choco-robot/HomeBot/docs/人体检测与跟随方案.md

# HomeBot 人体检测与跟随功能设计方案

**版本**: v2.0 (更新为YOLO26)  
**日期**: 2026-03-09  
**状态**: 待确认

---

## 1. 功能概述

实现机器人的**人体检测**和**自动跟随**功能：
- **人体检测**：实时识别画面中的人体位置
- **目标跟踪**：稳定跟踪特定目标（避免频繁切换）
- **自动跟随**：根据目标位置控制底盘移动，保持固定距离

---

## 2. 系统架构

### 2.1 模块架构

```
┌─────────────────────────────────────────────────────────────┐
│                   Application: human_follow                   │
│  ┌─────────────┐  ┌─────────────┐  ┌─────────────────────┐ │
│  │ Human       │  │ Target      │  │ FollowController    │ │
│  │ Detector    │→ │ Tracker     │→ │ (vx, vy, vz)       │ │
│  │ (YOLO26n)   │  │ (IoU/Kalman)│  │                     │ │
│  └─────────────┘  └─────────────┘  └─────────────────────┘ │
└─────────────────────────────────────────────────────────────┘
                              │
                              ↓ ZeroMQ REQ
┌─────────────────────────────────────────────────────────────┐
│                   Service: ChassisService                     │
│                    (接收跟随控制指令)                          │
└─────────────────────────────────────────────────────────────┘
                              ↑
                              │ ZeroMQ SUB
┌─────────────────────────────────────────────────────────────┐
│                   Service: VisionService                      │
│                    (发布摄像头图像帧)                          │
└─────────────────────────────────────────────────────────────┘
```

### 2.2 数据流

```
VisionService ──(ZMQ PUB)──→ human_follow ──(ZMQ REQ)──→ ChassisService
      │                           │                          │
   Camera帧                   检测+跟踪                    执行速度
   (MJPEG)                    计算速度指令                  控制底盘
```

---

## 3. 技术方案选型

### 3.1 人体检测方案对比

| 方案 | 速度 | 精度 | CPU占用 | 模型大小 | 推荐度 |
|---|---|---|---|---|---|
| **YOLO26-nano** | ⭐⭐⭐⭐⭐ | ⭐⭐⭐⭐ | 极低 | 2.4MB | ⭐⭐⭐⭐⭐ |
| YOLO11-nano | ⭐⭐⭐⭐ | ⭐⭐⭐⭐ | 低 | 2.6MB | ⭐⭐⭐⭐ |
| YOLOv8-nano | ⭐⭐⭐ | ⭐⭐⭐ | 低 | 3.2MB | ⭐⭐⭐ |
| MediaPipe | ⭐⭐⭐⭐ | ⭐⭐ | 极低 | - | ⭐⭐ |

**最终选择**: **YOLO26-nano** (2026年1月发布)
- **模型大小**: ~2.4MB（比YOLO11小8%，比YOLOv8小25%）
- **CPU速度**: 38.9ms/帧，比YOLO11快**43%**
- **精度**: 40.9% mAP（COCO），比YOLO11高1.4%
- **边缘优化**: 移除DFL模块，无NMS后处理，部署更简单

### 3.2 YOLO26 关键优势

| 特性 | YOLO26 | 说明 |
|---|---|---|
| **端到端推理** | ✅ NMS-free | 直接输出结果，无需后处理，延迟更低 |
| **DFL移除** | ✅ | 架构简化，支持更多导出格式 |
| **小目标检测** | ✅ ProgLoss+STAL | 专门优化小目标检测精度 |
| **量化稳定** | ✅ | FP16/FP32精度一致，适合INT8部署 |
| **MuSGD优化器** | ✅ | 训练更稳定，泛化能力更强 |

### 3.3 目标跟踪方案

| 方案 | 特点 | 适用场景 |
|---|---|---|
| **IoU匹配** | 简单、无状态 | 目标不重叠时 |
| **卡尔曼滤波** | 预测运动轨迹 | 目标短暂遮挡 |
| **DeepSORT** | 外观+运动特征 | 多目标、复杂场景 |

**推荐方案**: IoU匹配 + 卡尔曼滤波（混合）
- 轻量实现，适合树莓派/Jetson
- 处理简单跟随场景足够

### 3.4 跟随控制算法

**控制策略**：视觉伺服（Visual Servoing）

```python
# 控制逻辑伪代码
def compute_velocity(target_bbox, frame_width, frame_height):
    """
    根据目标位置计算底盘速度
    目标：将目标保持在画面中央，保持固定距离
    """
    cx, cy = get_bbox_center(target_bbox)
    area = get_bbox_area(target_bbox)
    
    # 1. 水平控制（角速度 vz）
    # 目标在画面左侧 → 左转，右侧 → 右转
    error_x = cx - frame_width / 2
    vz = Kp_angular * error_x  # P控制器
    
    # 2. 距离控制（线速度 vx）
    # 目标太小 → 靠近，太大 → 后退
    target_area = (frame_width * 0.3) * (frame_height * 0.5)  # 期望目标大小
    error_area = target_area - area
    vx = Kp_linear * error_area
    
    # 3. 速度限制
    vx = clamp(vx, -MAX_LINEAR_SPEED, MAX_LINEAR_SPEED)
    vz = clamp(vz, -MAX_ANGULAR_SPEED, MAX_ANGULAR_SPEED)
    
    return vx, 0, vz  # vy = 0（不前移不后退）
```

---

## 4. 详细设计

### 4.1 目录结构

```
software/
├── src/
│   ├── applications/
│   │   └── human_follow/
│   │       ├── __init__.py              # 入口脚本
│   │       ├── follow.py                # 主控制逻辑
│   │       ├── detector.py              # 人体检测器（YOLO26）
│   │       ├── tracker.py               # 目标跟踪器
│   │       └── controller.py            # 跟随控制器
│   ├── configs/
│   │   └── config.py                    # 新增HumanFollowConfig
│   └── models/                          # 模型文件目录
│       └── yolo26n.pt                   # YOLO26 nano模型 (~2.4MB)
├── tools/
│   └── download_models.py               # 模型下载脚本
```

### 4.2 类设计

#### 4.2.1 HumanDetector (人体检测器)

```python
class HumanDetector:
    """人体检测器 - 使用YOLO26"""
    
    def __init__(self, model_path: str, conf_threshold: float = 0.5):
        """
        Args:
            model_path: YOLO26模型文件路径
            conf_threshold: 置信度阈值
        """
        from ultralytics import YOLO
        self.model = YOLO(model_path)
        self.conf_threshold = conf_threshold
    
    def detect(self, frame: np.ndarray) -> List[Detection]:
        """
        检测图像中的人体
        
        Returns:
            List[Detection]: 检测框列表，每个包含:
                - bbox: [x1, y1, x2, y2]
                - confidence: 置信度
                - class_id: 类别ID (person=0)
        """
        results = self.model(frame, conf=self.conf_threshold, classes=[0])
        # 解析results为Detection列表
        return detections
```

#### 4.2.2 TargetTracker (目标跟踪器)

```python
class TargetTracker:
    """目标跟踪器 - IoU匹配 + 卡尔曼滤波"""
    
    def __init__(self, max_age: int = 30, min_iou: float = 0.3):
        """
        Args:
            max_age: 最大丢失帧数，超过则删除跟踪目标
            min_iou: 匹配最小IoU阈值
        """
        pass
    
    def update(self, detections: List[Detection]) -> Optional[Target]:
        """
        更新跟踪状态
        
        Args:
            detections: 当前帧检测结果
            
        Returns:
            Target: 当前跟踪目标（如果有）
        """
        pass
    
    def select_target(self, detections: List[Detection], 
                      strategy: str = "center") -> Target:
        """
        从多个检测中选择目标
        
        Args:
            strategy: 选择策略
                - "center": 选择画面中央的目标（默认）
                - "largest": 选择最大的目标
                - "closest": 选择最靠近摄像头的目标（框最大）
        """
        pass
```

#### 4.2.3 FollowController (跟随控制器)

```python
class FollowController:
    """跟随控制器 - 视觉伺服"""
    
    def __init__(self, config: FollowConfig):
        """
        Args:
            config: 跟随控制配置
        """
        pass
    
    def compute_velocity(self, target: Target, 
                         frame_shape: Tuple[int, int]) -> Tuple[float, float, float]:
        """
        计算跟随速度
        
        Returns:
            (vx, vy, vz): 线速度和角速度
        """
        pass
    
    def is_lost(self) -> bool:
        """判断目标是否丢失"""
        pass
    
    def reset(self):
        """重置控制器状态"""
        pass
```

#### 4.2.4 HumanFollowApp (主应用)

```python
class HumanFollowApp:
    """人体跟随主应用"""
    
    def __init__(self):
        # 初始化视觉订阅
        self.vision_sub = VisionSubscriber()
        # 初始化底盘客户端
        self.chassis_client = ChassisClient()
        # 初始化检测器、跟踪器、控制器
        self.detector = HumanDetector()
        self.tracker = TargetTracker()
        self.controller = FollowController()
        
    def run(self):
        """主循环"""
        while running:
            # 1. 获取图像
            frame_id, frame = self.vision_sub.read_frame()
            
            # 2. 检测人体
            detections = self.detector.detect(frame)
            
            # 3. 更新跟踪
            target = self.tracker.update(detections)
            
            # 4. 计算速度
            if target:
                vx, vy, vz = self.controller.compute_velocity(target, frame.shape)
                # 5. 发送控制命令
                self.chassis_client.send_velocity(vx, vy, vz, source="auto")
            else:
                # 目标丢失，停止或搜索
                self.chassis_client.stop()
```

### 4.3 配置设计

```python
@dataclass
class HumanFollowConfig:
    """人体跟随配置（YOLO26版）"""
    # 模型配置
    model_path: str = "models/yolo26n.pt"     # YOLO26 nano (~2.4MB)
    conf_threshold: float = 0.5
    
    # 跟踪配置
    max_tracking_age: int = 30        # 最大丢失帧数
    min_iou_threshold: float = 0.3    # 匹配阈值
    target_selection: str = "center"  # 目标选择策略
    
    # 推理优化（边缘设备）
    inference_size: int = 320         # 输入分辨率 320x320
    use_half_precision: bool = True   # FP16半精度推理
    
    # 跟随控制配置
    target_distance: float = 1.0      # 目标距离（米，通过框大小估算）
    kp_linear: float = 0.001          # 线速度P系数
    kp_angular: float = 0.003         # 角速度P系数
    max_linear_speed: float = 0.3     # 最大线速度
    max_angular_speed: float = 0.8    # 最大角速度
    dead_zone_x: int = 50             # 水平死区（像素）
    
    # 安全配置
    timeout_ms: int = 1000            # 通信超时
    stop_on_lost: bool = True         # 丢失目标时是否停止
```

---

## 5. 通信协议

### 5.1 控制命令格式

```json
{
    "source": "auto",
    "vx": 0.2,
    "vy": 0.0,
    "vz": 0.1,
    "priority": 3
}
```

- `source`: "auto" - 自动跟随控制源
- `priority`: 3 - 与仲裁器优先级定义一致（web=1, voice=2, auto=3, emergency=4）

### 5.2 视觉检测结果（可选扩展）

如需发布检测结果供其他模块使用：

```json
{
    "type": "detection.human",
    "timestamp": 1709568000,
    "data": {
        "targets": [
            {
                "id": 1,
                "bbox": [100, 200, 300, 400],
                "confidence": 0.95,
                "center": [200, 300]
            }
        ],
        "tracking": {
            "target_id": 1,
            "status": "tracking"
        }
    }
}
```

---

## 6. 异常处理与安全机制

### 6.1 异常场景处理

| 场景 | 处理策略 |
|---|---|
| **目标丢失** | 停止移动，原地旋转搜索或等待 |
| **多目标** | 按策略选择（中央/最大/最近） |
| **目标遮挡** | 卡尔曼滤波预测，最多持续N帧 |
| **通信中断** | 停止底盘，记录日志 |
| **检测失败** | 重试，连续失败则停止 |

### 6.2 安全机制

1. **速度限制**：配置最大线速度和角速度上限
2. **急停响应**：监听紧急停止信号，立即释放控制权
3. **超时保护**：通信超时自动停止底盘
4. **边界检测**：结合视觉避障，避免碰撞

---

## 7. 性能优化

### 7.1 YOLO26 推理优化

| 优化手段 | 说明 | 预期提升 |
|---|---|---|
| **输入分辨率降低** | 320x320 替代 640x640 | 4x速度提升 |
| **FP16半精度** | TensorRT/ONNX FP16 | 2x速度提升 |
| **NCNN** (ARM) | 树莓派/手机专用格式 | 2-3x速度提升 |
| **批量推理** | 一次处理多帧 | 提高吞吐量 |

### 7.2 各平台预期性能

| 平台 | 格式 | 分辨率 | 预期FPS | 延迟 |
|---|---|---|---|---|
| 树莓派5 | NCNN | 320x320 | 25-30 | ~35ms |
| Jetson Nano | TensorRT FP16 | 320x320 | 20-25 | ~45ms |
| Jetson Orin Nano | TensorRT FP16 | 640x640 | 40-50 | ~20ms |
| x86 CPU | ONNX | 320x320 | 15-20 | ~60ms |

### 7.3 控制优化

- **速度平滑**：使用低通滤波或滑动平均，避免速度突变
- **PID控制**：将P控制器升级为PID，减少抖动

---

## 8. 实现步骤

### Phase 1: 基础框架 (Day 1-2)
1. 新增配置文件 `HumanFollowConfig`
2. 实现 `HumanDetector` 类（YOLO26集成）
3. 模型下载脚本（自动下载yolo26n.pt）

### Phase 2: 跟踪与控制 (Day 3-4)
1. 实现 `TargetTracker` 类
2. 实现 `FollowController` 类
3. 视觉伺服算法调试

### Phase 3: 应用集成 (Day 5)
1. 实现 `HumanFollowApp` 主应用
2. 与底盘服务集成测试
3. 异常处理与安全机制

### Phase 4: 优化与测试 (Day 6-7)
1. 性能优化（异步、跳帧）
2. 参数调优
3. 编写测试用例

---

## 9. 依赖变更

```txt
# requirements.txt 新增依赖
ultralytics>=8.3.0      # YOLO26 (需最新版支持)
numpy>=1.24.0           # 数值计算
filterpy>=1.4.5         # 卡尔曼滤波（可选）

# 边缘设备优化（可选）
onnxruntime>=1.16.0     # ONNX推理
openvino>=2024.0        # Intel CPU优化
tensorrt>=10.0          # NVIDIA Jetson
```

---

## 10. 启动方式

```bash
# 方式一：独立启动
cd software/src
python -m applications.human_follow

# 方式二：通过系统启动脚本集成
# 修改 start_system.py 添加跟随模式选项

# 方式三：从Web控制端切换模式（未来扩展）
# 遥控界面添加"跟随模式"开关
```

---

## 11. 测试计划

| 测试项 | 方法 | 预期结果 |
|---|---|---|
| 人体检测精度 | 测试视频集 | mAP > 0.7 |
| 跟踪稳定性 | 多人场景测试 | 不频繁跳换目标 |
| 跟随效果 | 真人测试 | 保持1米距离，位于画面中央 |
| 异常处理 | 遮挡、丢失测试 | 安全停止或恢复 |
| 性能 | 树莓派/Jetson | FPS > 15 |

---

## 12. 附录：YOLO 版本对比

### 12.1 YOLO26 vs YOLO11 vs YOLOv8

| 指标 | YOLO26-nano | YOLO11-nano | YOLOv8-nano | 胜出 |
|---|---|---|---|---|
| **mAP** | 40.9% | 39.5% | 37.3% | YOLO26 |
| **CPU速度** | 38.9ms | 56.1ms | 80.4ms | YOLO26 |
| **参数量** | 2.4M | 2.6M | 3.2M | YOLO26 |
| **FLOPs** | 5.4B | 6.5B | 8.7B | YOLO26 |
| **NMS-free** | ✅ | ❌ | ❌ | YOLO26 |
| **发布时间** | 2026-01 | 2024-10 | 2023-01 | - |

### 12.2 选择YOLO26的理由

1. **最快CPU推理**: 比YOLO11快43%，比YOLOv8快107%
2. **更高精度**: 在更小模型下实现更高mAP
3. **无NMS**: 端到端推理，降低延迟和部署复杂度
4. **边缘优化**: 专为嵌入式和移动设备设计
5. **API兼容**: 与YOLOv8/YOLO11完全相同的Python接口

---

## 13. 风险评估

| 风险 | 影响 | 缓解措施 |
|---|---|---|
| YOLO26太新，社区资料少 | 调试困难 | 官方文档完善，API兼容YOLOv8/11 |
| 量化精度损失 | 检测精度下降 | FP16精度一致，INT8需测试 |
| 复杂背景误检 | 跟随错误目标 | 增加置信度阈值，优化跟踪逻辑 |
| 光线变化 | 检测失败 | 测试不同光照条件 |
| 多人干扰 | 频繁切换目标 | 改进目标选择策略 |

---

## 14. 后续扩展

1. **手势控制**：识别手势指令（停止、跟随、离开）
2. **人脸识别**：跟随特定人员
3. **路径预测**：预测目标移动方向，提前调整
4. **避障集成**：跟随同时避障

---

*方案设计完成（基于YOLO26），等待确认后开始实施*
