choco-robot/HomeBot/docs/HomeBot_BOM物料清单.md

# HomeBot 机器人 BOM 物料清单

本文档列出 HomeBot 机器人的完整物料清单（Bill of Materials）。

## 物料清单

| 分类 | 序号 | 名称 | 规格/型号 | 数量 | 备注 |
|:---:|-----:|---|---|:---:|:---|
| **车身** | 1 | 宜家小车 | Raskog小号 | 1套 | 基础平台 |
| | 2 | 锂电池 | 12V 5000mAh + 电源线 | 1 | 动力电源 |
| | 3 | 锂电池充电器 | 12V 配套充电器 | 1 | 安全充电 |
| | 4 | 舵机控制板 | Bus Servo Adapter (A) | 1 | 舵机通信控制 |
| | 5 | USB摄像头 | 1080P | 1 | 视觉采集 |
| **底盘** | 6 | 底盘3D打印件 | PLA/PETG | 1套 | 底盘框架主体 |
| | 7 | 底盘舵机 | ST3215 12V | 3 | 三轮全向底盘驱动 |
| | 8 | 法兰轴 | 6mm | 3 | 舵机与轮子连接 |
| | 9 | 全向轮 + 铜联轴器 | 85mm全向轮 + 6mm铜联轴器 | 3 | 轮子组件 |
| | 10 | 螺丝螺母 | M3/M4 | 若干 | 紧固件 |
| **机械臂** | 11 | SOARM101打印件 | PLA/PETG | 1套 | 机械臂结构件 |
| | 12 | 720P USB摄像头模组 | 125°无畸变镜头 | 1 | 机械臂视觉 |

---

*最后更新：2026-03-22*
