choco-robot/HomeBot/hardware/structure/STL/dualwheelbase/轮子无刷电机支架v2.3mf

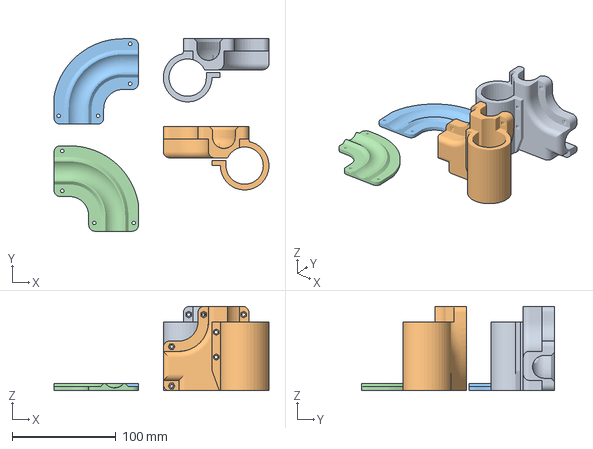
[picture p4: CAD file, 2026-06-03]
hardware/structure/STL/dualwheelbase/轮子无刷电机支架v2.3mf
207.5 x 185.8 x 81.5 mm
轮子无刷电机支架v2.STL x 2
盖板.STL x 2
