choco-robot/HomeBot/hardware/structure/STL/elevator/打孔工具.STL

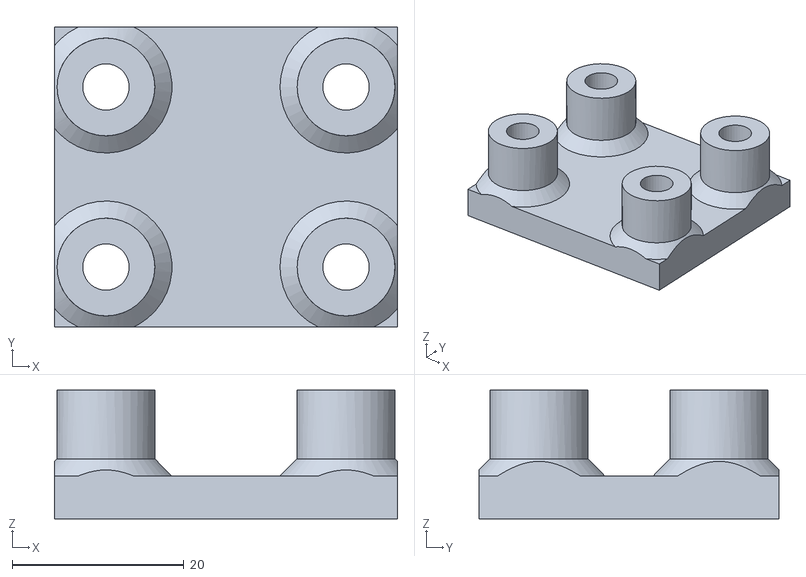
[picture p5: CAD file, 2026-03-27]
hardware/structure/STL/elevator/打孔工具.STL
40.0 x 35.0 x 15.0
