choco-robot/HomeBot/hardware/structure/STL/kiwi_base/base_plate_layer1.3mf

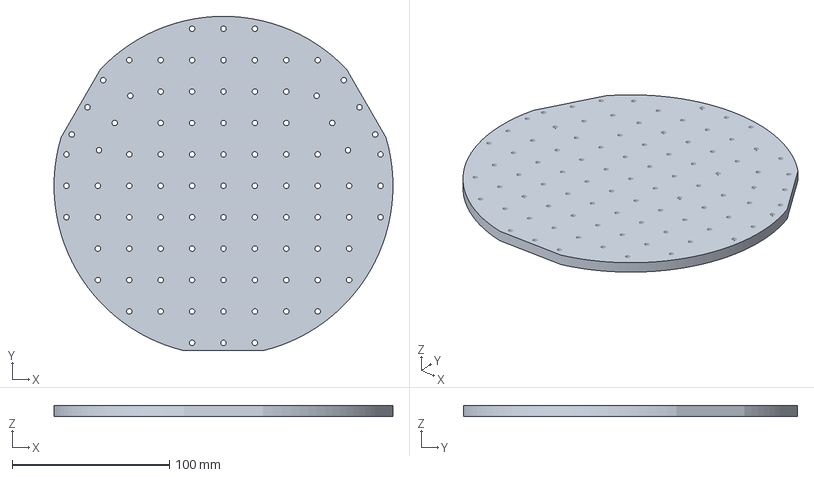
[picture p6: CAD file, 2026-06-03]
hardware/structure/STL/kiwi_base/base_plate_layer1.3mf
215.9 x 212.9 x 7.00 mm
