choco-robot/HomeBot/hardware/structure/STL/SO-ARM101_camera_wrist_mount.stl

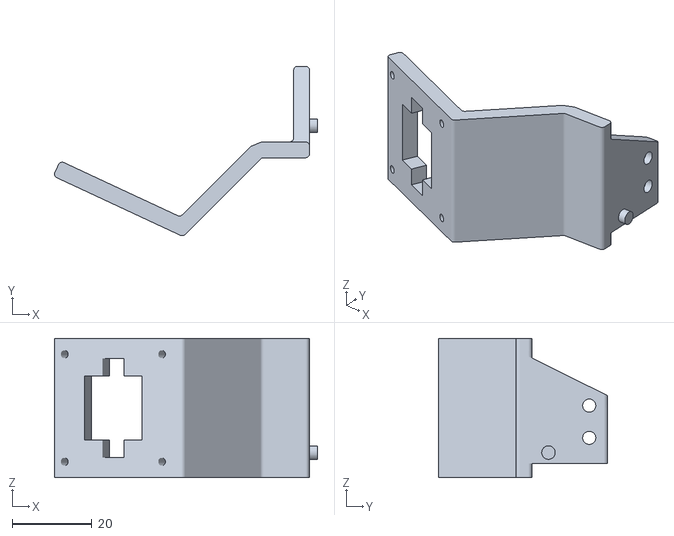
[picture p7: CAD file, 2026-03-22]
hardware/structure/STL/SO-ARM101_camera_wrist_mount.stl
66.1 x 42.6 x 35.0
