choco-robot/HomeBot/hardware/structure/URDF/SO101/assets/wrist_roll_pitch_so101_v2.stl

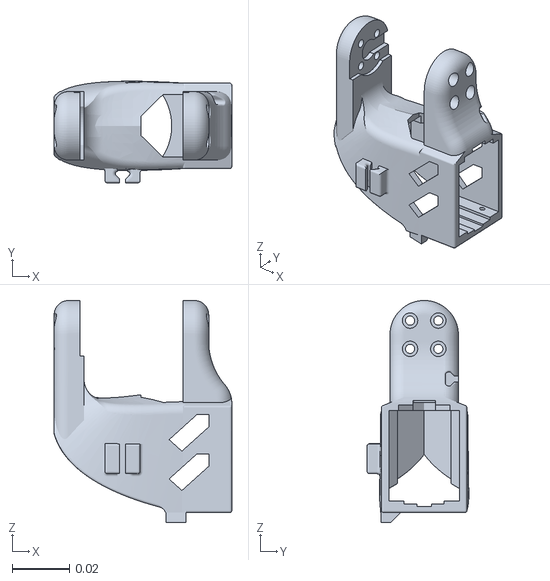
[picture p8: CAD file, 2026-04-28]
hardware/structure/URDF/SO101/assets/wrist_roll_pitch_so101_v2.stl
0.0623 x 0.0357 x 0.0778
