choco-robot/HomeBot/hardware/structure/STL/dualwheelbase/盖板.3mf

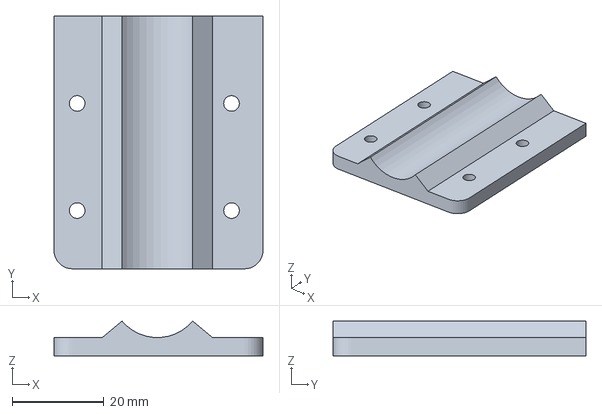
[picture p9: CAD file, 2026-06-03]
hardware/structure/STL/dualwheelbase/盖板.3mf
45.5 x 55.0 x 7.60 mm
