choco-robot/HomeBot/hardware/structure/STL/elevator/丝杆轴承连接座.STL

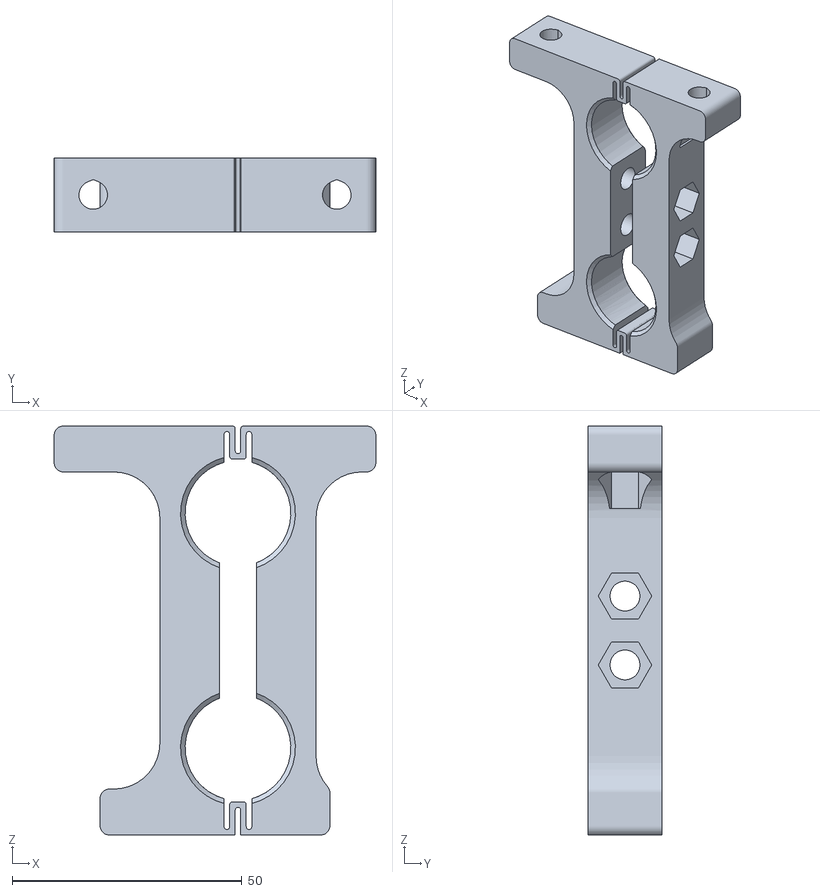
[picture p10: CAD file, 2026-03-13]
hardware/structure/STL/elevator/丝杆轴承连接座.STL
70.0 x 16.0 x 89.0
