choco-robot/HomeBot/hardware/structure/STL/kiwi_base/base_connector_45mm.3mf

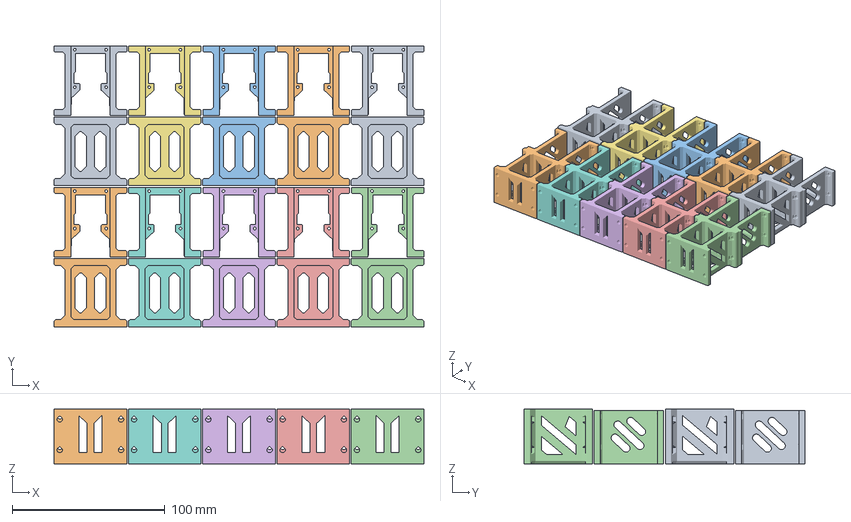
[picture p11: CAD file, 2026-06-03]
hardware/structure/STL/kiwi_base/base_connector_45mm.3mf
242.1 x 184.0 x 35.8 mm
组合体
组合体 1
组合体 2
组合体 3
组合体 4
组合体 5
组合体 6
组合体 7
组合体 8
组合体 9
