choco-robot/HomeBot/hardware/structure/URDF/SO101/assets/moving_jaw_so101_v1.stl

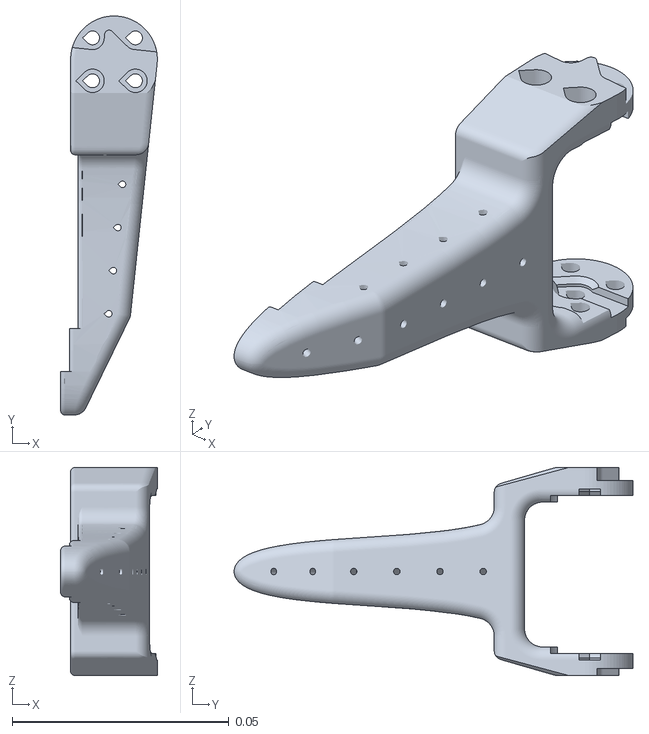
[picture p12: CAD file, 2026-04-28]
hardware/structure/URDF/SO101/assets/moving_jaw_so101_v1.stl
0.0223 x 0.092 x 0.048
