choco-robot/HomeBot/hardware/structure/STL/dualwheelbase/轮子无刷电机支架.3mf

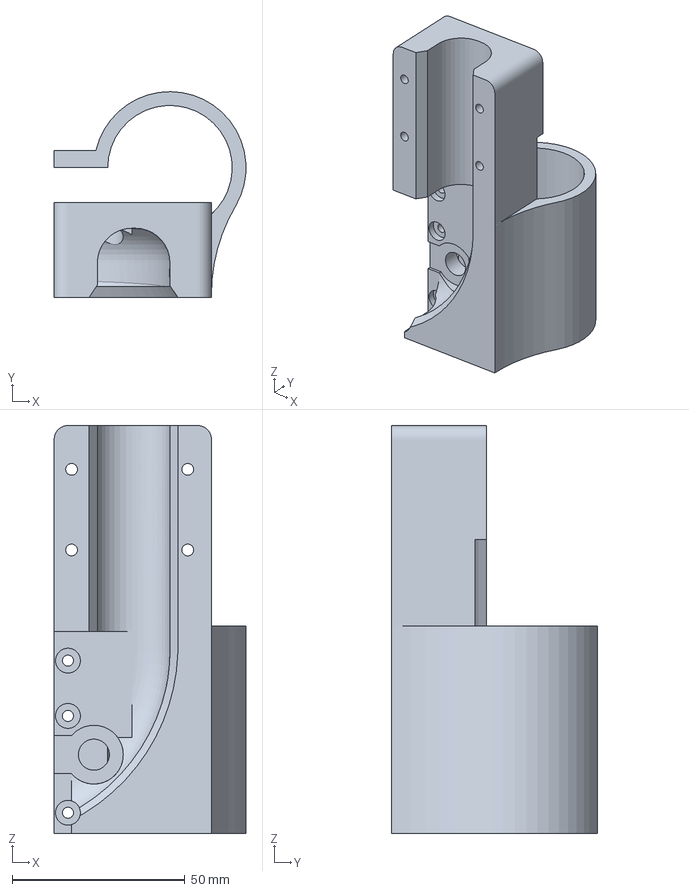
[picture p13: CAD file, 2026-06-03]
hardware/structure/STL/dualwheelbase/轮子无刷电机支架.3mf
55.5 x 59.5 x 118.0 mm
