choco-robot/HomeBot/hardware/structure/STL/elevator/丝杠舵机座.STL

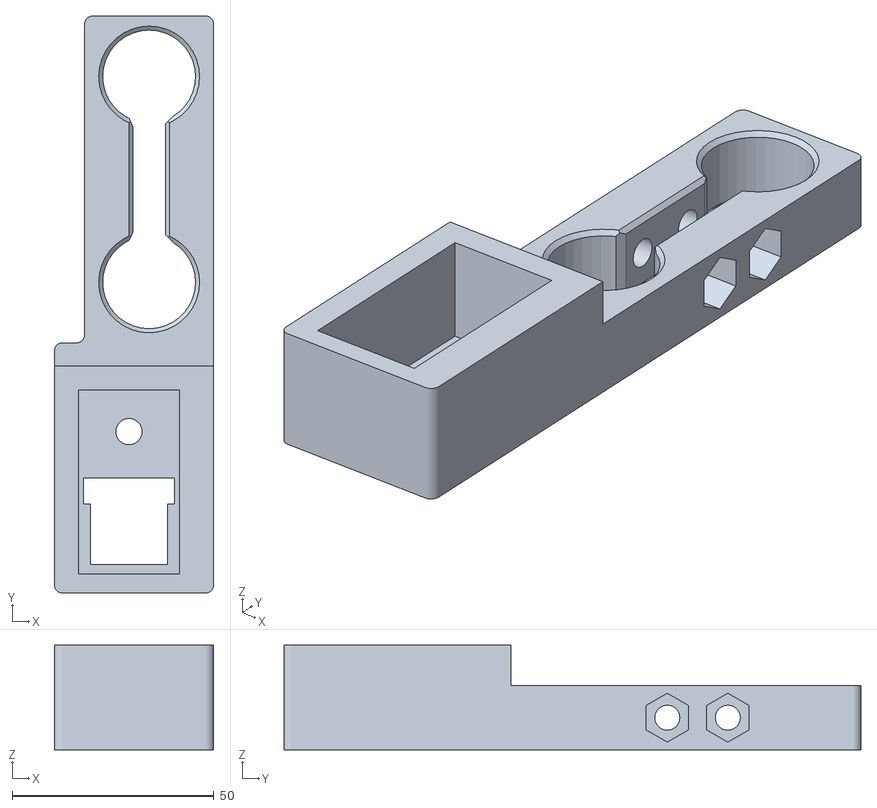
[picture p14: CAD file, 2026-03-13]
hardware/structure/STL/elevator/丝杠舵机座.STL
39.5 x 143.0 x 26.0
