choco-robot/HomeBot/hardware/structure/STL/kiwi_base/drive_motor_mount_v2.stl

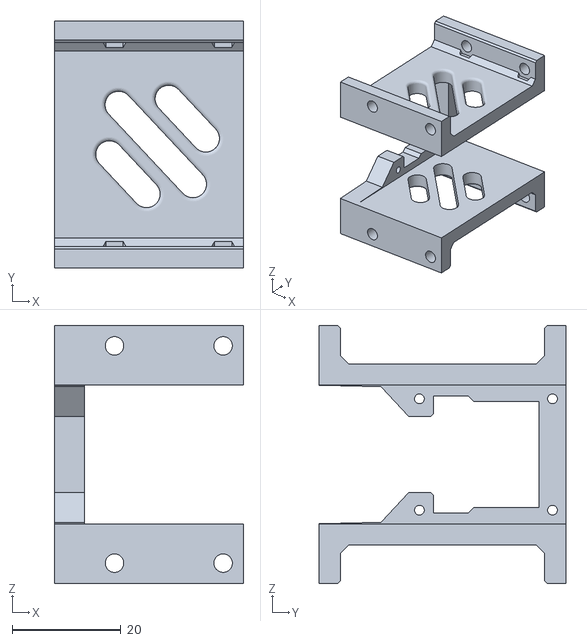
[picture p15: CAD file, 2026-03-13]
hardware/structure/STL/kiwi_base/drive_motor_mount_v2.stl
34.8 x 45.5 x 47.5
