choco-robot/HomeBot/hardware/structure/URDF/SO101/assets/base_motor_holder_so101_v1.stl

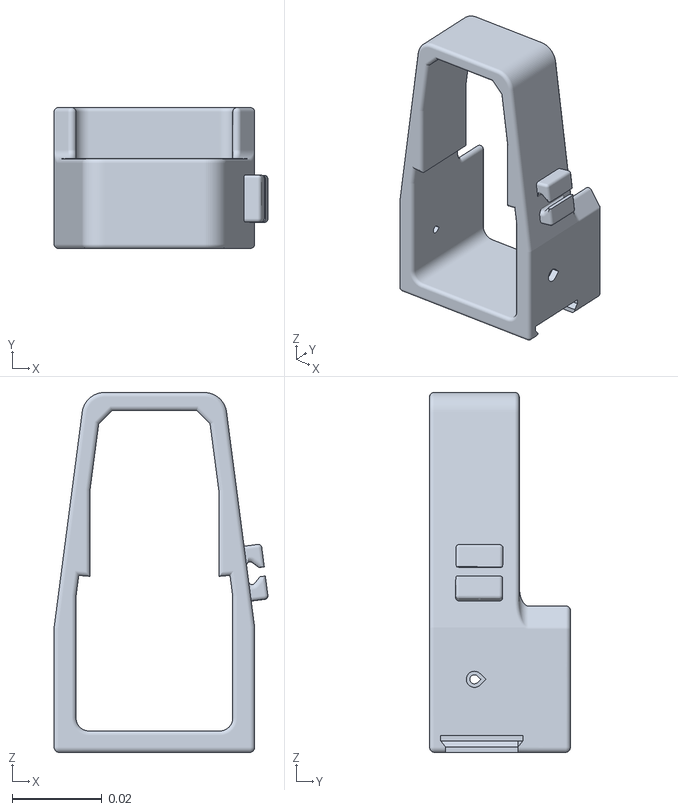
[picture p16: CAD file, 2026-04-28]
hardware/structure/URDF/SO101/assets/base_motor_holder_so101_v1.stl
0.0476 x 0.0314 x 0.0802
