choco-robot/HomeBot/hardware/structure/STL/kiwi_base/base_plate_layer2.stl

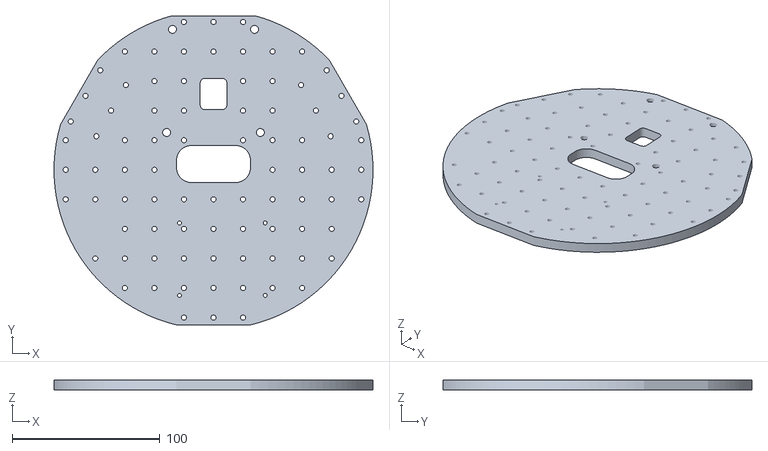
[picture p17: CAD file, 2026-03-13]
hardware/structure/STL/kiwi_base/base_plate_layer2.stl
215.9 x 209.0 x 7.00
