choco-robot/HomeBot/hardware/structure/URDF/SO101/assets/waveshare_mounting_plate_so101_v2.stl

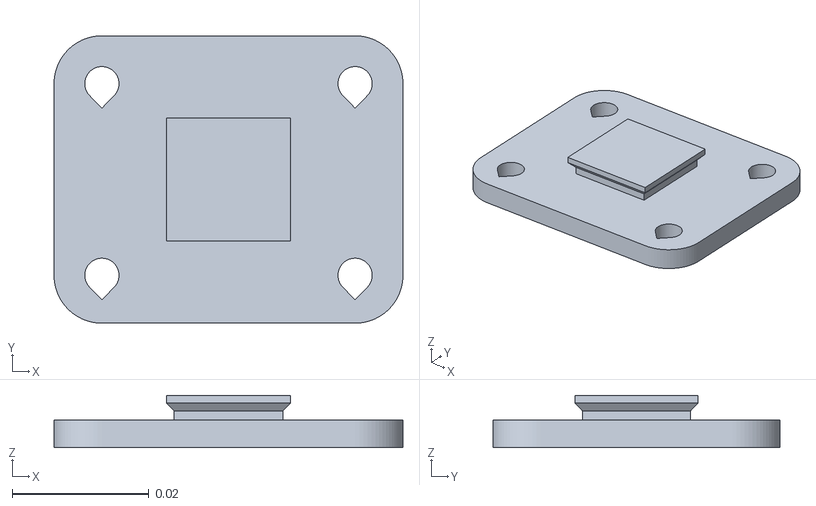
[picture p18: CAD file, 2026-04-28]
hardware/structure/URDF/SO101/assets/waveshare_mounting_plate_so101_v2.stl
0.051 x 0.042 x 0.0076
