choco-robot/HomeBot/hardware/structure/URDF/SO101/assets/motor_holder_so101_wrist_v1.stl

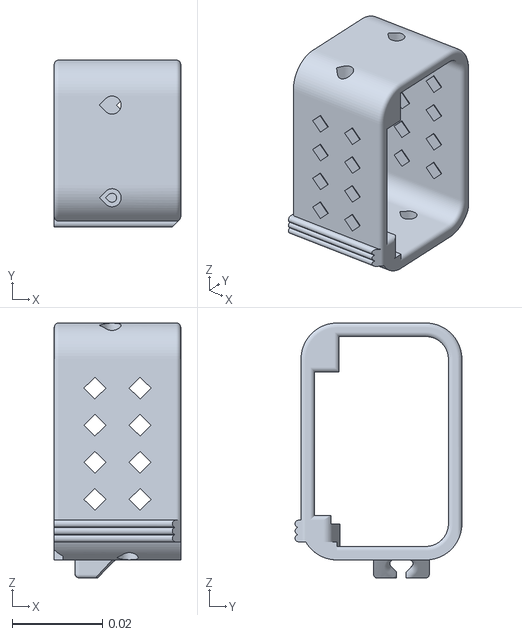
[picture p19: CAD file, 2026-04-28]
hardware/structure/URDF/SO101/assets/motor_holder_so101_wrist_v1.stl
0.028 x 0.0369 x 0.0564
