choco-robot/HomeBot/hardware/structure/URDF/SO101/assets/under_arm_so101_v1.stl

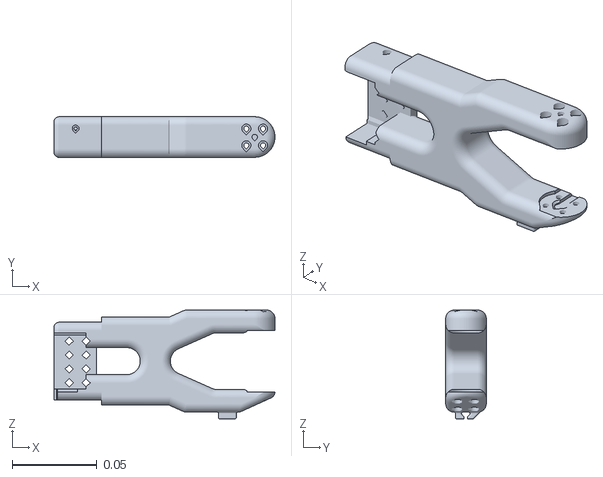
[picture p21: CAD file, 2026-04-28]
hardware/structure/URDF/SO101/assets/under_arm_so101_v1.stl
0.131 x 0.024 x 0.0644
