choco-robot/HomeBot/hardware/structure/URDF/SO101/assets/upper_arm_so101_v1.stl

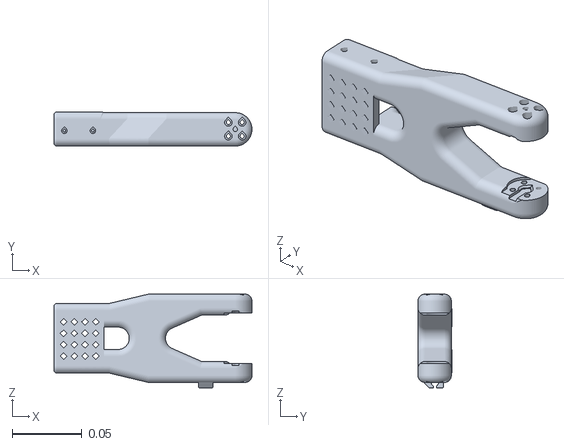
[picture p22: CAD file, 2026-04-28]
hardware/structure/URDF/SO101/assets/upper_arm_so101_v1.stl
0.142 x 0.0245 x 0.0673
