choco-robot/HomeBot/hardware/structure/URDF/SO101/assets/rotation_pitch_so101_v1.stl

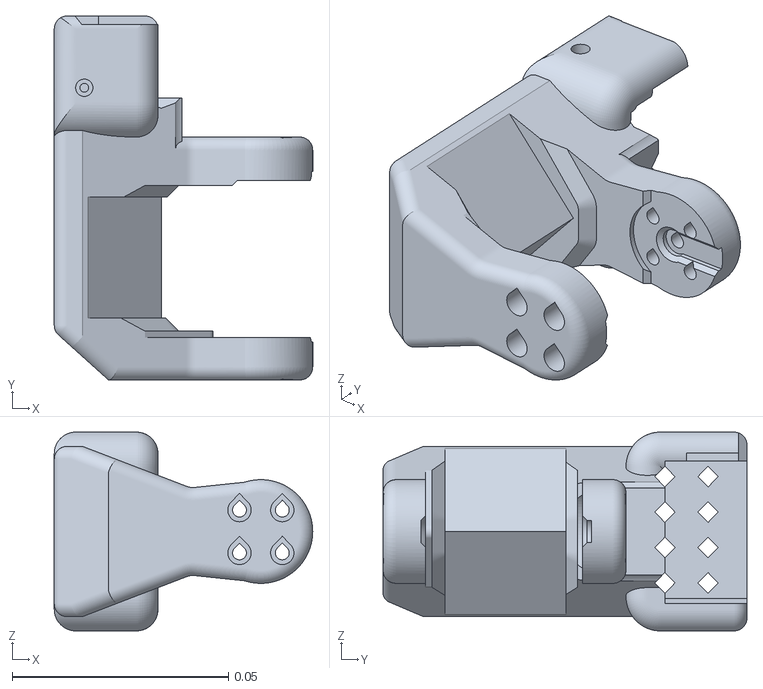
[picture p23: CAD file, 2026-04-28]
hardware/structure/URDF/SO101/assets/rotation_pitch_so101_v1.stl
0.0598 x 0.0842 x 0.046
