choco-robot/HomeBot/hardware/structure/URDF/SO101/assets/wrist_roll_follower_so101_v1.stl

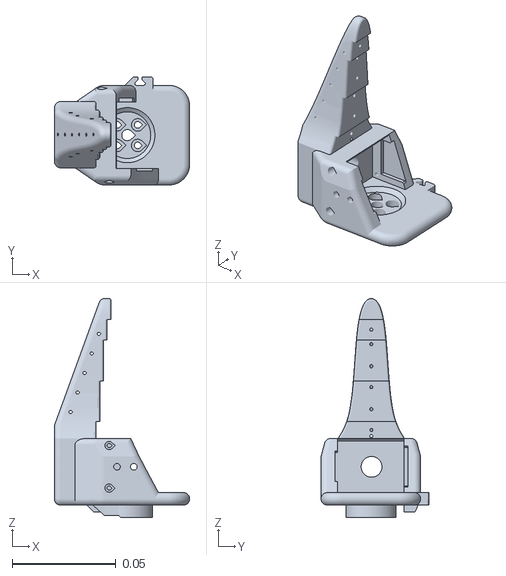
[picture p24: CAD file, 2026-04-28]
hardware/structure/URDF/SO101/assets/wrist_roll_follower_so101_v1.stl
0.0652 x 0.052 x 0.105
