choco-robot/HomeBot/hardware/structure/URDF/SO101/assets/sts3215_03a_v1.stl

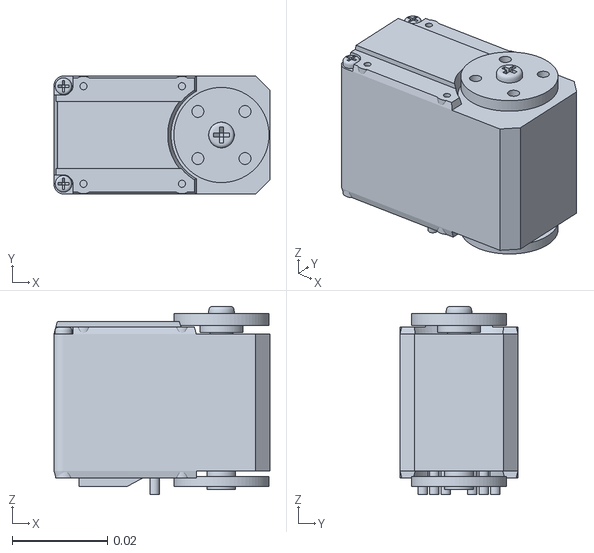
[picture p25: CAD file, 2026-04-28]
hardware/structure/URDF/SO101/assets/sts3215_03a_v1.stl
0.0454 x 0.0248 x 0.0396
