choco-robot/HomeBot/hardware/structure/URDF/SO101/assets/base_so101_v2.stl

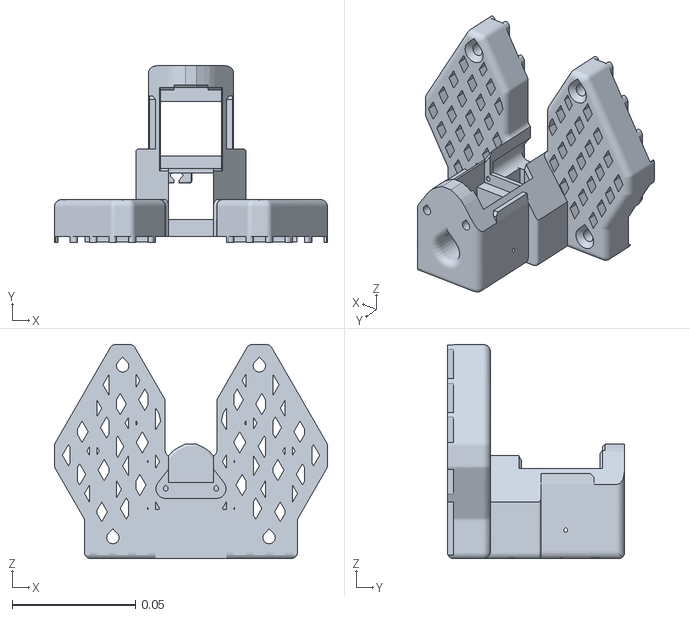
[picture p26: CAD file, 2026-04-28]
hardware/structure/URDF/SO101/assets/base_so101_v2.stl
0.111 x 0.072 x 0.087
