choco-robot/HomeBot/(list of files, cad)

Other CAD files:
hardware/structure/STL/dualwheelbase/盖板.STL
hardware/structure/STL/dualwheelbase/轮子无刷电机支架.STL
hardware/structure/STL/dualwheelbase/轮子无刷电机支架v2.STL
hardware/structure/STL/kiwi_base/base_connector_45mm.stl
hardware/structure/STL/kiwi_base/base_plate_layer1.stl
