choco-robot/HomeBot/software/src/services/motion_service/chassis_service.py

"""
底盘服务
从配置文件读取硬件参数
"""
import os
import sys
import threading
import time
from typing import Optional, Dict, Any
from dataclasses import dataclass, asdict
from threading import Lock

import zmq
from .chassis_arbiter import ControlCommand, ArbiterResponse, PRIORITIES
from .servo_bus_manager import ServoBusManager, get_servo_bus
from hal.chassis.driver import ChassisDriver
from hal.battery.driver import BatteryDriver
from common.logging import get_logger
from common.messages import MessageType, serialize
from configs import get_config, ChassisConfig, BatteryConfig

logger = get_logger(__name__)


@dataclass
class ChassisCommand:
    """底盘指令数据结构"""
    vx: float
    vy: float
    vz: float
    source: str
    priority: int
    timestamp: float


class RealChassisController:
    """真实底盘控制器 - 从配置文件读取串口等参数"""
    
    def __init__(self, config: Optional[ChassisConfig] = None, bus=None):
        # 从全局配置读取，或使用传入的配置
        self.config = config or get_config().chassis
        # 支持传入外部总线（共享模式）
        self.driver = ChassisDriver(self.config, bus=bus)
        self._initialized = False
        
    def initialize(self) -> bool:
        """初始化底盘硬件"""
        print("[RealChassis] 正在初始化底盘硬件...")
        print(f"[RealChassis] 串口: {self.config.serial_port}, 波特率: {self.config.baudrate}")
        
        if self._initialized:
            return True
            
        if not self.driver.initialize():
            print("[RealChassis] 底盘初始化失败！")
            return False
            
        self._initialized = True
        print("[RealChassis] 底盘初始化成功")
        return True
    
    def set_velocity(self, vx: float, vy: float, vz: float) -> bool:
        """设置底盘速度"""
        if not self._initialized:
            print("[RealChassis] 错误：底盘未初始化")
            return False
        
        return self.driver.set_velocity(vx, vy, vz)
    
    def stop(self) -> None:
        """停止底盘运动"""
        if self._initialized:
            self.driver.stop()
    
    def close(self) -> None:
        """关闭底盘驱动"""
        if self._initialized:
            self.driver.close()
            self._initialized = False


class ChassisService:
    """
    底盘服务 - 合并仲裁器和执行端
    从 configs/config.py 读取硬件配置
    集成电池状态监测和发布
    """
    
    TIMEOUT_MS = 1000
    
    def __init__(self, 
                 rep_addr: Optional[str] = None, 
                 pub_addr: Optional[str] = None,
                 use_shared_bus: bool = False):
        """
        初始化底盘服务
        
        Args:
            rep_addr: ZeroMQ REP地址，默认从配置文件读取
            pub_addr: 电池状态PUB地址，默认从配置文件读取
            use_shared_bus: 是否使用共享串口总线（与机械臂共用）
        """
        # 从配置文件读取地址
        config = get_config().chassis
        battery_config = get_config().battery
        self.rep_addr = rep_addr or config.service_addr
        self.pub_addr = pub_addr or battery_config.pub_addr
        
        # 电池配置
        self._battery_config = battery_config
        self._battery_publish_interval = battery_config.publish_interval
        
        # 创建真实底盘控制器
        self._servo_bus = None
        if use_shared_bus:
            # 使用共享总线
            self._servo_bus = get_servo_bus()
            self.chassis = RealChassisController(config, bus=self._servo_bus)
        else:
            # 独立模式 - 暂时不创建，初始化时获取bus
            self.chassis = RealChassisController(config)
            self._servo_bus = self.chassis.driver.bus  # 获取底盘的舵机总线用于电池读取
        
        # 创建电池驱动
        self.battery = BatteryDriver(
            servo_bus=self._servo_bus,
            servo_ids=battery_config.servo_ids,
            full_voltage=battery_config.full_voltage,
            low_voltage=battery_config.low_voltage,
            critical_voltage=battery_config.critical_voltage,
            min_voltage=battery_config.min_voltage
        )
        
        # 控制权状态
        self._current_owner: Optional[str] = None
        self._current_priority: int = 0
        self._last_command_time: float = 0.0
        self._last_vx = 0.0
        self._last_vy = 0.0
        self._last_vz = 0.0
        
        # 紧急停止锁定状态 - 一旦触发，必须通过归位解除
        self._emergency_locked: bool = False
        
        # 电池状态发布
        self._last_battery_publish_time: float = 0.0
        self._last_battery_state = None

        # 电池监测后台线程（读取+发布移出控制主循环，避免阻塞串口读 stall 控制链路）
        self._battery_stop_event = threading.Event()
        self._battery_thread: Optional[threading.Thread] = None

        # _execute_to_hardware 日志去重状态（仅在速度/来源/结果变化时输出）
        self._last_exec_log_state = None

        self._lock = Lock()
        self._context: Optional[zmq.Context] = None
        self._rep_socket: Optional[zmq.Socket] = None
        self._pub_socket: Optional[zmq.Socket] = None
        self._running = False
        
    def _check_timeout(self) -> None:
        """检查当前控制权是否超时"""
        if self._current_owner is None:
            return
            
        elapsed_ms = (time.time() - self._last_command_time) * 1000
        if elapsed_ms > self.TIMEOUT_MS:
            print(f"[CHASSIS_SVC] 控制权超时释放: {self._current_owner}")
            self._current_owner = None
            self._current_priority = 0
            self._last_vx = self._last_vy = self._last_vz = 0.0
            self.chassis.stop()
    
    def _publish_battery_state(self, force: bool = False) -> None:
        """
        发布电池状态
        
        Args:
            force: 是否强制发布（忽略时间间隔）
        """
        current_time = time.time()
        
        # 检查是否需要发布（根据时间间隔）
        if not force:
            elapsed = current_time - self._last_battery_publish_time
            if elapsed < self._battery_publish_interval:
                return
        
        # 读取电池状态
        battery_state = self.battery.read_state()
        self._last_battery_state = battery_state
        
        if battery_state.is_valid and self._pub_socket:
            # 构建消息
            msg_data = {
                "voltage": round(battery_state.voltage, 2),
                "percentage": round(battery_state.percentage, 1),
                "status": battery_state.status.value,
                "temperature": battery_state.temperature,
                "servo_id": battery_state.servo_id
            }
            
            message = serialize(
                msg_type=MessageType.BATTERY_STATE,
                data=msg_data,
                timestamp=current_time
            )
            
            try:
                self._pub_socket.send_json(message, flags=zmq.NOBLOCK)
                self._last_battery_publish_time = current_time
                
                # 只在状态变化或低电量时打印日志
                if (battery_state.status.value in ["low", "critical"] or force):
                    print(f"[CHASSIS_SVC] [BATTERY] {battery_state.voltage:.1f}V "
                          f"({battery_state.percentage:.0f}%) - {battery_state.status.value}")
            except zmq.Again:
                # 发送缓冲区满，忽略
                pass
            except Exception as e:
                print(f"[CHASSIS_SVC] 电池状态发布失败: {e}")
        
        # 低电量警告
        if battery_state.is_valid and self.battery.is_critical_battery():
            print(f"[CHASSIS_SVC] [WARNING] 电池电量严重不足！请立即充电！")

    def _battery_loop(self) -> None:
        """
        电池监测后台线程：周期性读取电池状态并发布，顺带做低频舵机在线校验。

        电池读取是阻塞串口 TxRx（单次超时约 50ms），放在独立线程避免 stall 控制主循环。
        串口互斥由 FTServoBus 方法内部锁保证，无需在此持锁。
        """
        while self._running:
            # 按发布间隔等待，停止事件可立即打断
            if self._battery_stop_event.wait(self._battery_publish_interval):
                break
            if self._servo_bus is None:
                continue
            self._publish_battery_state()
            self._verify_wheel_servos()

    def _verify_wheel_servos(self) -> None:
        """
        低频校验轮子舵机在线状态（一次 SYNC_READ 同步读读回 3 个轮子的位置）。

        补偿 sync write（txOnly）无回包、写失败无感知的风险。
        """
        bus = self._servo_bus
        if bus is None or not bus.is_connected():
            return

        chassis_cfg = get_config().chassis
        wheel_ids = [chassis_cfg.left_front_id, chassis_cfg.right_front_id, chassis_cfg.rear_id]
        try:
            positions = bus.sync_read_positions(wheel_ids)
        except Exception as e:
            logger.warning(f"[CHASSIS_SVC] 舵机校验异常: {e}")
            return

        for wheel_id in wheel_ids:
            if positions.get(wheel_id) is None:
                logger.warning(f"[CHASSIS_SVC] 舵机校验失败: 轮子舵机 ID {wheel_id} 无响应，"
                               f"同步写指令可能未生效")
    
    def _arbitrate(self, cmd: ControlCommand) -> ArbiterResponse:
        """仲裁核心逻辑"""
        with self._lock:
            self._check_timeout()
            
            # 处理紧急停止 - 最高优先级，会锁定底盘
            if cmd.source == "emergency" or (cmd.vx == 0 and cmd.vy == 0 and cmd.vz == 0 and cmd.priority >= 4):
                self._emergency_locked = True
                self._current_owner = "emergency"
                self._current_priority = 4
                self._last_command_time = time.time()
                self._last_vx = self._last_vy = self._last_vz = 0.0
                self.chassis.stop()
                print("[CHASSIS_SVC] [EMERGENCY] 紧急停止已触发，底盘已锁定")
                return ArbiterResponse(
                    success=True,
                    message="紧急停止已触发，底盘已锁定",
                    current_owner="emergency",
                    current_priority=4
                )
            
            # 处理归位命令 - 解除紧急停止锁定
            if cmd.source == "home" or getattr(cmd, 'command', None) == 'home':
                was_locked = self._emergency_locked
                self._emergency_locked = False
                self._current_owner = None
                self._current_priority = 0
                self._last_vx = self._last_vy = self._last_vz = 0.0
                self.chassis.stop()
                msg = "紧急停止已解除，底盘归位" if was_locked else "底盘归位"
                print(f"[CHASSIS_SVC] [HOME] {msg}")
                return ArbiterResponse(
                    success=True,
                    message=msg,
                    current_owner="none",
                    current_priority=0
                )
            
            # 如果处于紧急停止锁定状态，拒绝所有运动命令
            if self._emergency_locked:
                return ArbiterResponse(
                    success=False,
                    message="底盘处于紧急停止锁定状态，请先点击归位解除",
                    current_owner="emergency",
                    current_priority=4
                )
            
            new_priority = cmd.priority
            
            if self._current_owner is None:
                self._current_owner = cmd.source
                self._current_priority = new_priority
                self._last_command_time = time.time()
                self._last_vx, self._last_vy, self._last_vz = cmd.vx, cmd.vy, cmd.vz
                self._execute_to_hardware(cmd)
                
                return ArbiterResponse(
                    success=True,
                    message="指令已接受",
                    current_owner=cmd.source,
                    current_priority=new_priority
                )
            
            elif new_priority >= self._current_priority:
                old_owner = self._current_owner
                self._current_owner = cmd.source
                self._current_priority = new_priority
                self._last_command_time = time.time()
                self._last_vx, self._last_vy, self._last_vz = cmd.vx, cmd.vy, cmd.vz
                self._execute_to_hardware(cmd)
                
                msg = "抢占控制权" if old_owner != cmd.source else "续期控制权"
                return ArbiterResponse(
                    success=True,
                    message=f"指令已接受（{msg}）",
                    current_owner=cmd.source,
                    current_priority=new_priority
                )
            else:
                return ArbiterResponse(
                    success=False,
                    message=f"优先级不足，当前被 {self._current_owner} 占用",
                    current_owner=self._current_owner,
                    current_priority=self._current_priority
                )
    
    def _execute_to_hardware(self, cmd: ControlCommand) -> None:
        """执行指令到底盘硬件"""
        success = self.chassis.set_velocity(cmd.vx, cmd.vy, cmd.vz)
        # 仅在速度/来源/执行结果变化时输出，避免心跳式重复指令刷屏
        log_state = (cmd.vx, cmd.vy, cmd.vz, cmd.source, success)
        if log_state != self._last_exec_log_state:
            self._last_exec_log_state = log_state
            status = "OK" if success else "FAIL"
            print(f"[CHASSIS_SVC] [{status}] vx={cmd.vx:+.2f}, vz={cmd.vz:+.2f} [from {cmd.source}]")
    
    def _parse_request(self, data: Dict[str, Any]) -> Optional[ControlCommand]:
        """解析REQ请求数据"""
        try:
            source = data.get("source", "")
            vx = float(data.get("vx", 0.0))
            vy = float(data.get("vy", 0.0))
            vz = float(data.get("vz", 0.0))
            priority = int(data.get("priority", 0))
            
            if priority == 0 and source in PRIORITIES:
                priority = PRIORITIES[source]
            
            return ControlCommand(
                source=source, vx=vx, vy=vy, vz=vz,
                priority=priority, timestamp=time.time()
            )
        except (KeyError, ValueError, TypeError) as e:
            print(f"[CHASSIS_SVC] 解析请求失败: {e}")
            return None
    
    def start(self) -> None:
        """启动底盘服务"""
        print("=" * 60)
        print("HomeBot 底盘服务")
        print("=" * 60)
        
        # 从配置读取的信息
        config = get_config().chassis
        battery_config = get_config().battery
        print(f"[配置] 串口: {config.serial_port}")
        print(f"[配置] 波特率: {config.baudrate}")
        print(f"[配置] 最大线速度: {config.max_linear_speed} m/s")
        print(f"[配置] 服务地址: {self.rep_addr}")
        print(f"[配置] 电池发布地址: {self.pub_addr}")
        print(f"[配置] 电池发布间隔: {self._battery_publish_interval}s")
        
        # 初始化底盘硬件
        if not self.chassis.initialize():
            print("[CHASSIS_SVC] 底盘硬件初始化失败，退出")
            return
        
        # 更新电池驱动的舵机总线引用（如果之前是独立模式，现在才获得bus）
        if self._servo_bus is None:
            self._servo_bus = self.chassis.driver.bus
            self.battery.set_servo_bus(self._servo_bus)
        
        # 启动ZeroMQ
        self._context = zmq.Context()
        
        # REP socket用于接收控制命令（10ms 阻塞接收超时，替代 NOBLOCK 忙轮询）
        self._rep_socket = self._context.socket(zmq.REP)
        self._rep_socket.setsockopt(zmq.LINGER, 0)
        self._rep_socket.setsockopt(zmq.RCVTIMEO, 10)
        self._rep_socket.bind(self.rep_addr)
        
        # PUB socket用于发布电池状态
        self._pub_socket = self._context.socket(zmq.PUB)
        self._pub_socket.setsockopt(zmq.LINGER, 0)
        self._pub_socket.bind(self.pub_addr)
        
        self._running = True
        print("[CHASSIS_SVC] 底盘服务已启动，等待控制源连接...")
        print("=" * 60)
        
        # 发布一次初始电池状态
        self._publish_battery_state(force=True)

        # 启动电池监测后台线程（周期性读取+发布电池状态，含低频舵机校验）
        self._battery_thread = threading.Thread(
            target=self._battery_loop, name="battery-monitor", daemon=True
        )
        self._battery_thread.start()

        try:
            while self._running:
                try:
                    request_data = self._rep_socket.recv_json()
                    cmd = self._parse_request(request_data)

                    if cmd is None:
                        response = ArbiterResponse(
                            success=False, message="请求格式错误",
                            current_owner=self._current_owner or "none",
                            current_priority=self._current_priority
                        )
                    else:
                        response = self._arbitrate(cmd)

                    self._rep_socket.send_json(asdict(response))

                except zmq.Again:
                    # RCVTIMEO 超时：做控制权超时检查等 housekeeping
                    with self._lock:
                        self._check_timeout()
                    continue
                    
        except KeyboardInterrupt:
            print("\n[CHASSIS_SVC] 正在关闭...")
        finally:
            self.stop()
    
    def stop(self) -> None:
        """停止底盘服务"""
        if not getattr(self, '_stopped', False):
            self._stopped = True
            self._running = False
            # 停止电池监测后台线程，避免关闭后继续访问串口
            self._battery_stop_event.set()
            if self._battery_thread is not None:
                self._battery_thread.join(timeout=1.0)
                self._battery_thread = None
            self.chassis.stop()
            self.chassis.close()
            if self._rep_socket:
                self._rep_socket.close()
                self._rep_socket = None
            if self._pub_socket:
                self._pub_socket.close()
                self._pub_socket = None
            if self._context:
                self._context.term()
                self._context = None
            print("[CHASSIS_SVC] 已关闭")


def main():
    """主入口 - 支持命令行参数覆盖配置文件"""
    import argparse
    
    parser = argparse.ArgumentParser(description='HomeBot 底盘服务')
    parser.add_argument('--port', default=None, help='覆盖配置文件的串口')
    parser.add_argument('--addr', default=None, help='覆盖配置文件的ZeroMQ REP地址')
    parser.add_argument('--battery-addr', default=None, help='覆盖配置文件的电池状态PUB地址')
    parser.add_argument('--shared-bus', action='store_true', help='使用共享串口总线（与机械臂共用）')
    
    args = parser.parse_args()
    
    # 如果有命令行参数，修改配置
    if args.port:
        get_config().chassis.serial_port = args.port
        print(f"[命令行] 覆盖串口为: {args.port}")
    
    rep_addr = args.addr or get_config().chassis.service_addr
    battery_addr = args.battery_addr or get_config().battery.pub_addr
    
    service = ChassisService(
        rep_addr=rep_addr, 
        pub_addr=battery_addr,
        use_shared_bus=args.shared_bus
    )
    service.start()


if __name__ == '__main__':
    main()
