choco-robot/HomeBot/(commit log)

2026-03-06 Add automated test suite for chassis arbitration system
2026-03-08 删除SW结构原文件
    [10mm光轴.SLDPRT, GB - Spur gear 1.5M 16T 20PA 8FW ---S16B18H18L10.0N.STL, GB - Spur gear 1.5M 64T 20PA 8FW ---S64A75H50L5.0N.STL, KP000_10.SLDPRT, ST3215-20200328-to-customer.stp.SLDASM, T10丝杆.SLDPRT, UM2E_丝杆轴承连接座.3mf, Uxcell-LM10UU-ball-bearing-bushing.SLDPRT]
2026-03-09 feat: 新增人体跟随功能 + 更新文档
    主要更新:
    - 新增人体跟随应用 (human_follow)，基于 YOLO26 实现实时人体检测与跟踪
    - 实现视觉伺服控制算法，自动跟随目标人体
    - 新增检测器 (detector.py)、跟踪器 (tracker.py)、控制器 (controller.py)
    - 新增一键启动脚本 start_system.py 和 start_human_follow.py
    - 新增工具脚本：模型下载、ONNX 导出
    文档更新:
    - 更新 README.md，详细介绍人体跟随功能和使用方法
    - 新增人体跟随使用指南 (docs/人体跟随使用指南.md)
    - 新增人体检测与跟随技术方案文档 (docs/人体检测与跟随方案.md)
    - 新增 AGENTS.md 项目开发指南
    配置更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
2026-03-10 feat: 添加机械臂支持，修复人体跟随 ZeroMQ 连接问题
    主要变更：
    - 新增机械臂服务 (arm_service) 和 HAL 驱动
    - 添加舵机总线共享管理，底盘和机械臂共用串口
    - 新增机械臂运动学模块 (Kinematics.py)
    - Web控制端支持机械臂归位 (move to home)
    - 修复人体跟随 ZeroMQ 地址配置错误 (tcp://* -> tcp://localhost)
    - 修复人体跟随模型路径问题
    - 更新配置管理，添加 rest_position 等配置
    - 新增机械臂相关测试和诊断工具
    - 重构 chassis_service，使用共享总线管理器
    [Kinematics.py, __main__.py, arm_service.py, chassis_service.py, driver.py]
2026-03-10 增加用picoclaw控制homebot的文档
2026-03-10 feat:添加web端的机械臂控制功能
2026-03-12 更新底盘打印件STL
    [19mm bore internal retaining ring_am.sldprt, EV232-27005539.stp, GB - Spur gear 1.5M 16T 20PA 8FW ---S16B18H18L10.0N.sldprt, GB - Spur gear 1.5M 64T 20PA 8FW ---S64A75H50L5.0N.sldprt, base_connector_47mm.stl, base_plate_layer1.stl, base_plate_layer2.stl, drive_motor_mount_v2.stl]
2026-03-13 更新文档
2026-03-13 更新配置修改说明文档和应用开发指南文档
2026-03-13 更新readme
2026-03-13 优化web端机械臂控制功能
2026-03-13 update:优化web端的机械臂控制界面，增加x方向前后移动按钮
2026-03-17 在calibrate_arm中增加角度极限设置
2026-03-17 更新requirements
2026-03-17 fix:修复start_system脚本在windows下启动异常的问题
2026-03-22 新增BOM表
    [SO-ARM101_camera_wrist_mount.stl]
2026-03-22 新增设备查看工具脚本
2026-03-27 homebot-skill更新
2026-03-27 更新picoclaw配置文档
2026-03-27 homebot-plus 第一次提交 增加了平台升降控制功能
2026-03-28 feat:更新升降功能
2026-03-28 fix:修复了平台升降bug问题，增加了自动复位功能
2026-03-28 更新homebot-skill，支持平台升降
2026-03-29 fix:修复Kinematis.py中关于wrist_flex角度的计算 fix:修复calibrate_arm中无法自动释放扭矩的问题
2026-03-29 更新Readme新增校准说明
2026-04-22 文档更新：新增关于模型下载的说明
2026-04-28 feat:更新视频服务，增加AtomS3R-M12摄像头模块的支持
2026-04-28 合并homebot-mahjong分支: URDF模型和基于ikpy的运动学计算
    - 新增SO-101机械臂URDF模型及相关STL零件文件
    - 新增Arm3DKinematics类，基于ikpy结合URDF实现5DOF精确逆运动学
    - requirements.txt添加ikpy>=3.4.2依赖
    [base_motor_holder_so101_v1.stl, base_so101_v2.stl, motor_holder_so101_base_v1.stl, motor_holder_so101_wrist_v1.stl, moving_jaw_so101_v1.stl, rotation_pitch_so101_v1.stl, so101_new_calib.urdf, so101_old_calib.urdf]
2026-04-28 feat:增加机械臂人脸跟踪功能
2026-06-03 prepare for merge
    [base_connector_45mm.3mf, base_plate_layer1.3mf, 盖板.3mf, 盖板.STL, 轮子无刷电机支架.3mf, 轮子无刷电机支架.STL, 轮子无刷电机支架v2.3mf, 轮子无刷电机支架v2.STL]
2026-06-03 docs: 添加 Choco-Arm 分支合并更新记录
    - README.md 新增 2026-04-28 更新概要
    - docs/更新记录.md 添加完整的 Choco-Arm 更新记录
    - SO-101 URDF 模型与 ikpy 精确逆运动学
    - AtomS3R-M12 网络摄像头支持
    - 机械臂人脸跟踪功能
    - 语音交互 MCP 增强
    - 新增硬件结构零件
2026-07-06 fix:优化了camera driver中opencv后端的适配，并尝试设置图像格式为MJPEG以节省带宽
2026-07-06 feat(gamepad): add Linux native joystick backend for Ubuntu
    - Add linux_js_backend.py based on /dev/input/js* (no pygame dep)
    - Platform dispatch in __init__.py: win32 -> xinput_core, linux -> linux_js_backend, others -> pygame_backend
    - Keep API consistent with xinput_core (ControllerState, StickState, ButtonFlags)
    - Update AGENTS.md gamepad driver description
2026-07-09 update docs/工具脚本使用指南.md.
2026-07-09 fix(configs): 支持 LLM_PROVIDER 环境变量并增强 TTS 403 诊断
    - secrets.py: LLMSecrets 新增 provider 字段，支持 LLM_PROVIDER/DEEPSEEK_PROVIDER/VOLCANO_PROVIDER
    - config.py: LLMConfig 根据 provider 自动设置默认 api_url 和 model
    - tts_client.py: 捕获 HTTP 403 并打印响应头/体，方便定位认证问题
    - tests/test_llm.py: 新增 LLM 连接诊断脚本
    - .env.example: 增加 LLM_PROVIDER 配置说明
    修复 .env.local 中 LLM_PROVIDER=deepseek 不生效的问题
2026-07-09 feat(arm_teleop): 增加机械臂 WLAN 遥操作应用
    - 新增 applications/arm_teleop/ 模块：
    - master_reader: 读取本地 SO101 主臂角度
    - slave_client: 通过 ZeroMQ REQ-REP 连接远端 arm_service
    - app: 关节映射/限幅/死区、速度自适应、通信失败保护、运行模式
    - recorder: 轨迹录制与回放，支持速度缩放与循环
    - keyboard_input: 运行时热键控制
    - gui: tkinter 简易 GUI
    - __main__: CLI 入口，支持 --gui/--record/--playback 等参数
    - 新增 tests/test_arm_teleop.py 遥操作测试
    - 新增 tools/build_arm_teleop_exe.py PyInstaller 打包脚本
    - 更新 HAL 层 arm driver、ftservo_driver 以支持遥操作所需接口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
2026-07-09 docs: 更新 README 和更新记录，补充 2026-07-09 LLM 配置与机械臂 WLAN 遥操作
2026-08-24 feat: 新增通用消息总线与 homebot CLI 工具
    - 新增 services/message_bus：XPUB-XSUB 代理（5590/5591），支持用户自定义消息扩展
    - 新增 common/bus.py：BusPublisher/BusSubscriber/ZMQRequestClient 通用客户端
    - common/messages.py 开放消息类型，支持任意字符串类型（user.*/ext.* 前缀约定）
    - 新增 homebot_cli：homebot start/stop/restart/status/logs/topic/move/doctor/completion
    - 新增 tools/build_homebot_cli_exe.py：CLI 打包为单文件 exe
    - 修复 common/logging.py 循环导入导致日志级别错误回退为 DEBUG 的问题
    - 修复 homebot start 在 Windows 上因子进程重定向器弹出空控制台窗口的问题
    - 新增 tests/t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
    [__main__.py]
2026-08-24 docs: README 更新记录补充 2026-08-24 版本，预告 SLAM 导航模块（homebot-navi 分支）
2026-08-26 perf(hal+vision): 舵机总线同步写与并发安全、视觉链路降带宽与崩溃修复
    底盘/舵机链路:
    - 底盘轮速改用 SYNC_WRITE 广播一次下发3轮, 速度不变跳过串口写, 指令RTT ~5-15ms降至~0.6ms
    - FTServoBus 串口访问方法内部持 RLock(单次事务粒度), 修复共享总线模式下底盘/机械臂/电池多线程串包隐患
    - 多舵机读取改用 SYNC_READ 批量读(sync_read_positions/sync_read_states), 机械臂6关节查询12次串口事务降为1次
    - get_state 改用 ReadPosSpeed 单次读取; 电池读取移到后台线程, 修正默认 servo_id([1]->[7])消除周期stall
    - 底盘服务主循环改 RCVTIMEO 阻塞接收, 指令日志按状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
    [arm_service.py, chassis_service.py, driver.py, ftservo_driver.py]
2026-08-26 docs: 更新记录补充 2026-08-26 HAL/通信层性能优化（舵机总线+视觉链路）
2026-08-26 docs: 修正更新记录中的年份错误（2025→2026）
