choco-robot/HomeBot/(notices)

Notices in the files:
README.md:
License: MIT
